mvlamis/wig/images_documentation/3d_prints/final_model_motor_case.png

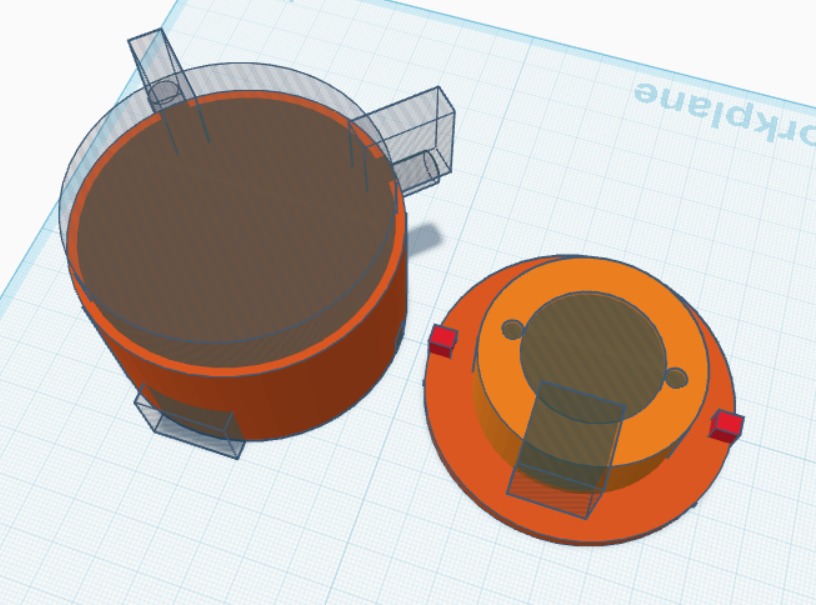
images_documentation/3d_prints/final_model_motor_case.png
