mvlamis/wig/README.md

# Infringement
**Michael Vlamis & Mars Lapierre-Furtado**

### [Code](./code)
### [Images](./images_documentation)
### [Diagrams](./diagrams)
### [Reports](./PDFs)
### [Technical Overview Video](https://youtu.be/p-mDJJXL3-0)
### [Conceptual Overview Video](https://youtu.be/cWO9dPNXsRk)
