mvlamis/wig/diagrams/early-blueprint.jpg

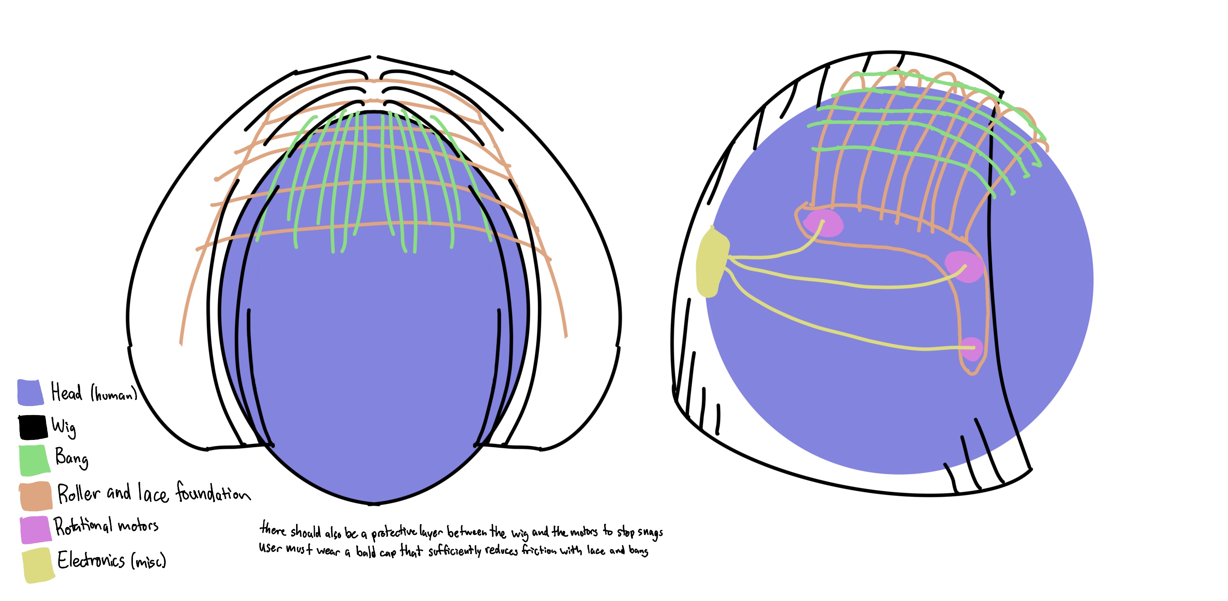
diagrams/early-blueprint.jpg
