mvlamis/wig/diagrams/motor-model.jpg

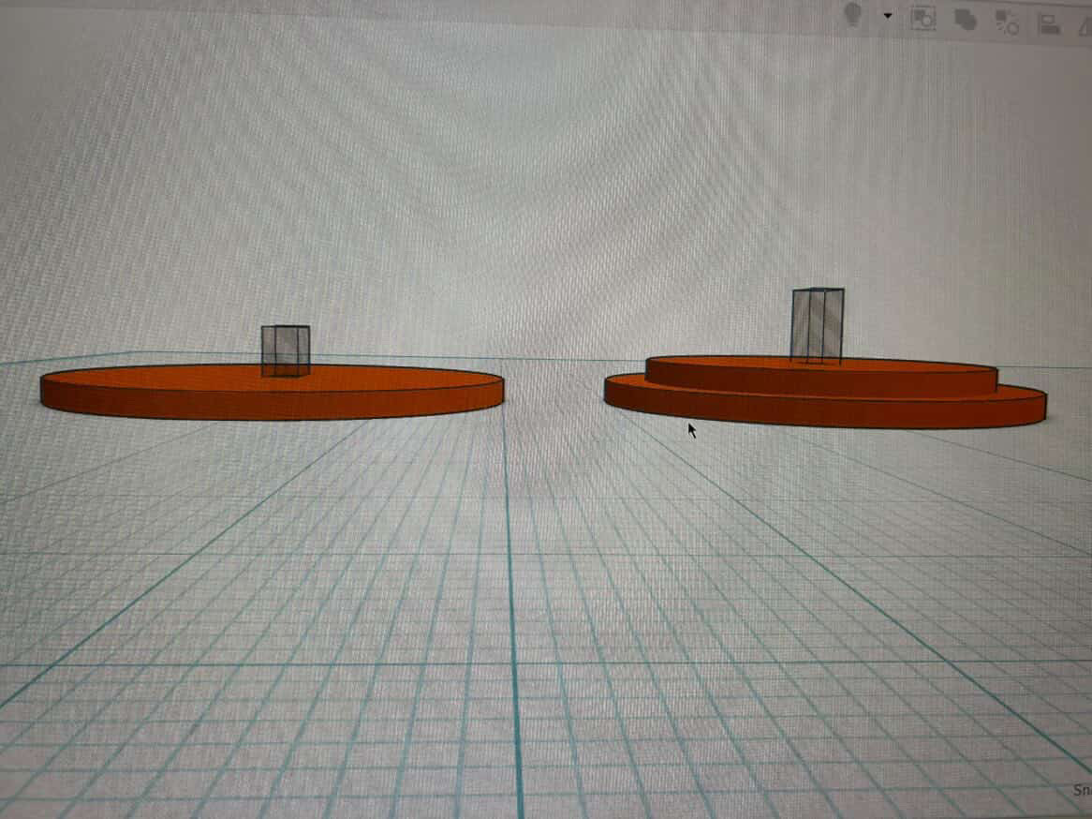
diagrams/motor-model.jpg
