mvlamis/wig/diagrams/sketch1.jpg

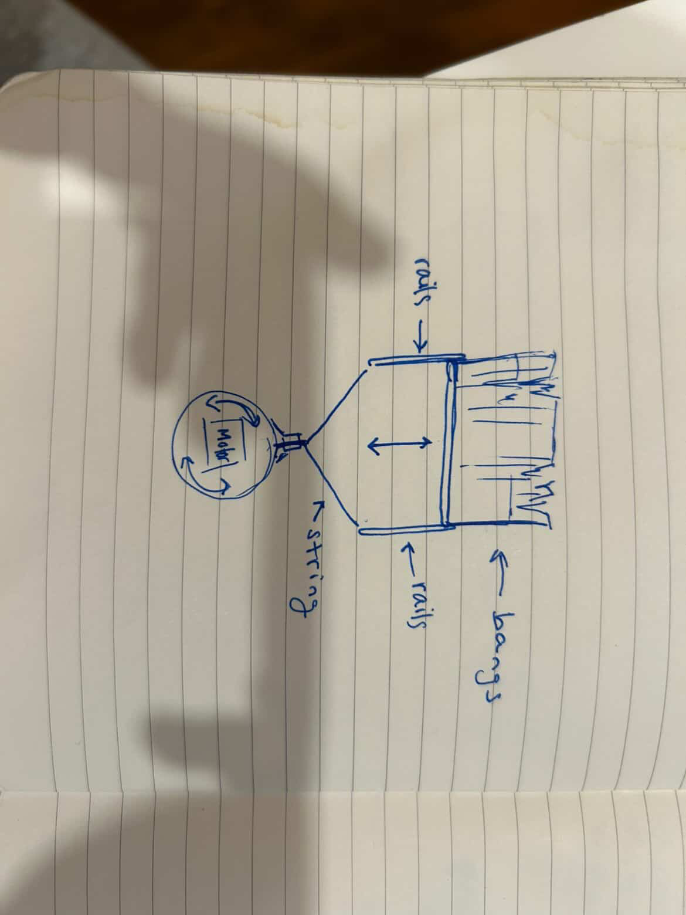
diagrams/sketch1.jpg
