mvlamis/wig/diagrams/sketch2.jpg

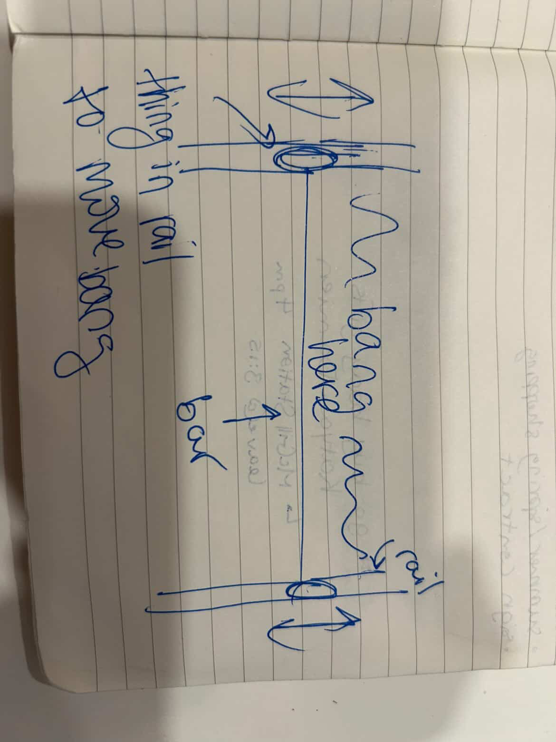
diagrams/sketch2.jpg
