mvlamis/wig/diagrams/Storyboard.png

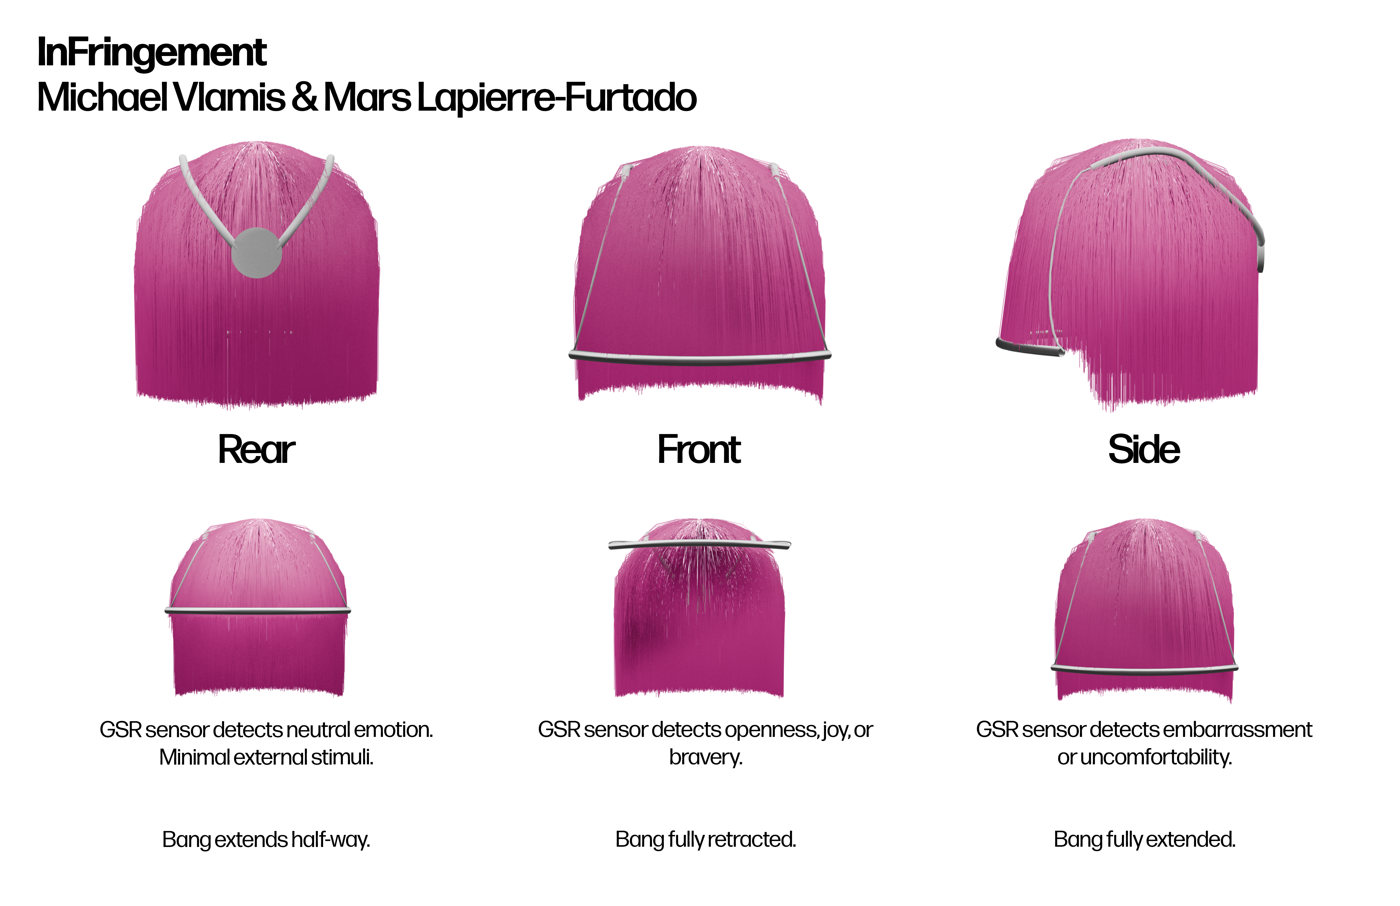
diagrams/Storyboard.png
