mvlamis/wig/diagrams/Wig Sketch_bb.png

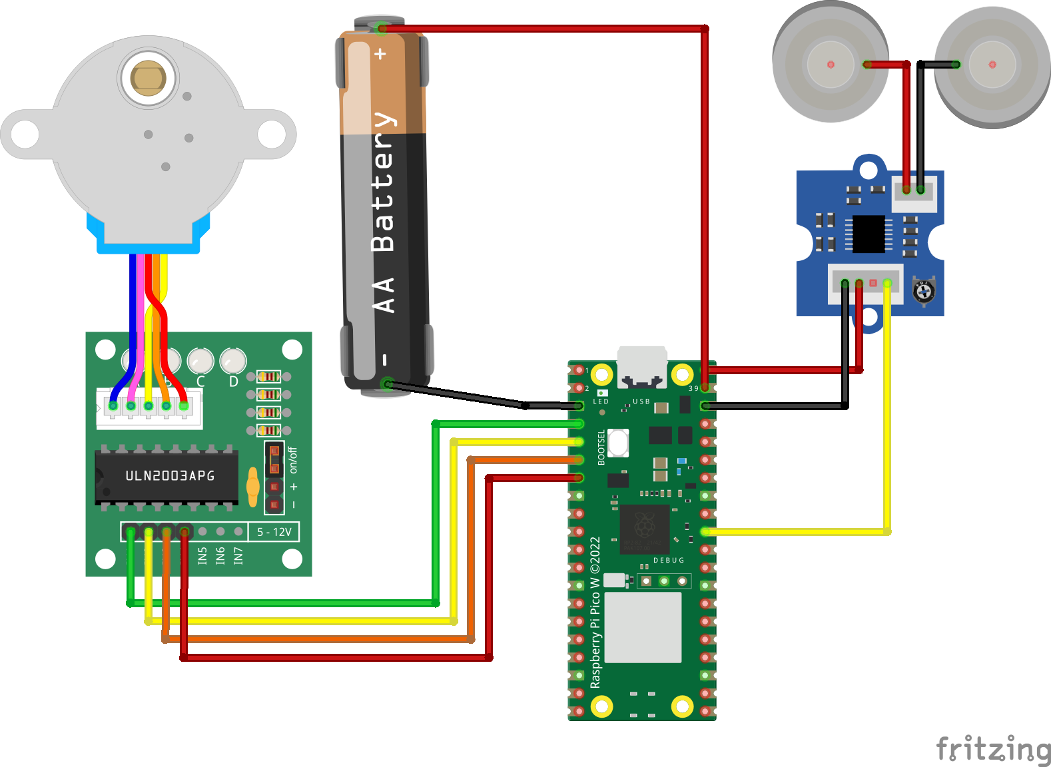
diagrams/Wig Sketch_bb.png
