mvlamis/wig/images_documentation/arm.JPG

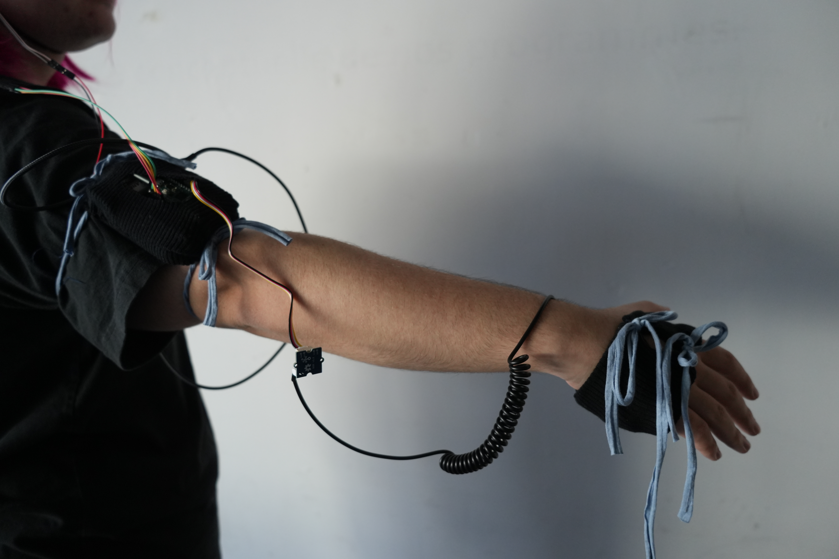
images_documentation/arm.JPG
