mvlamis/wig/images_documentation/fabric_secured.jpeg

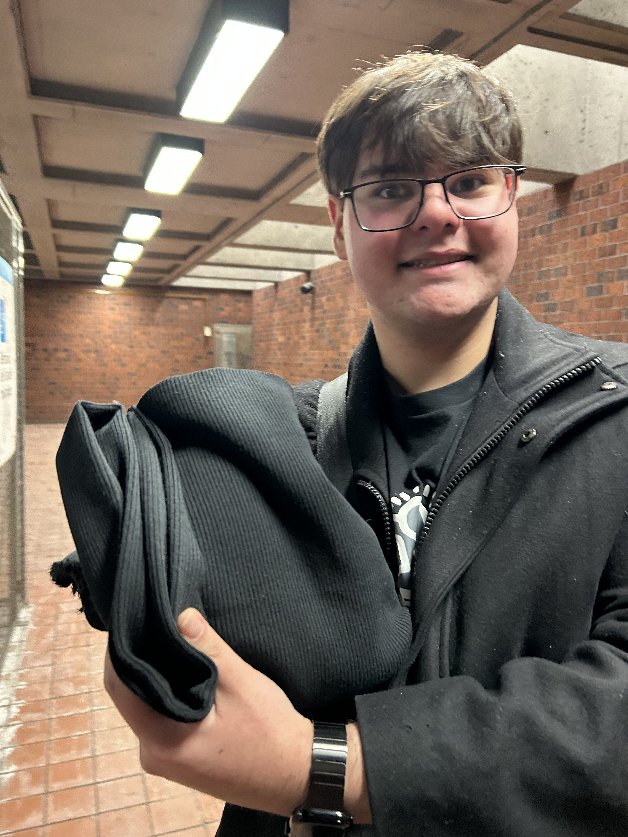
images_documentation/fabric_secured.jpeg
