mvlamis/wig/images_documentation/home_depot_success.jpg

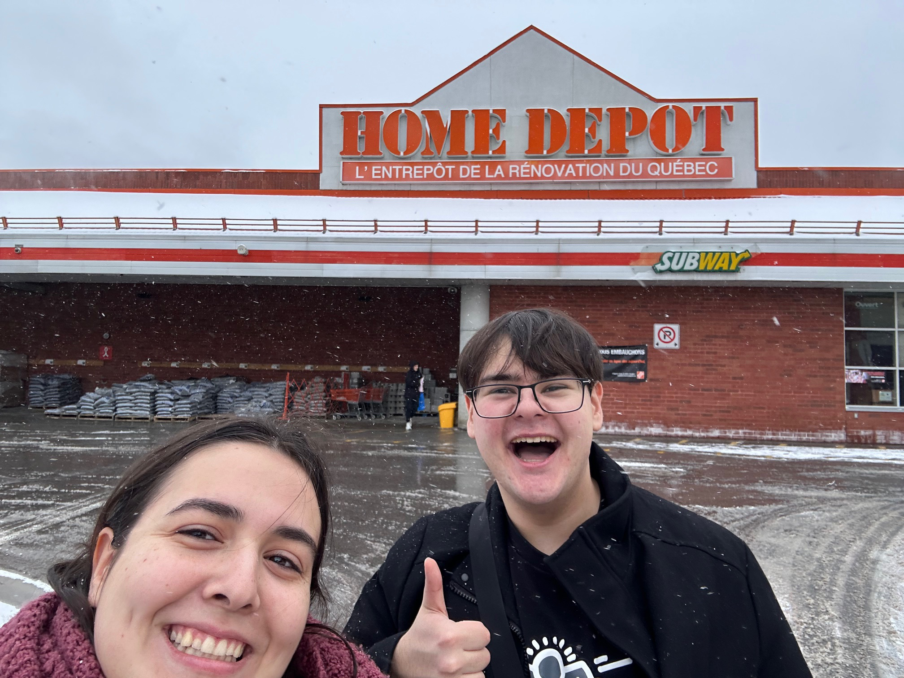
images_documentation/home_depot_success.jpg
