mvlamis/wig/images_documentation/sensor-concoction.jpeg

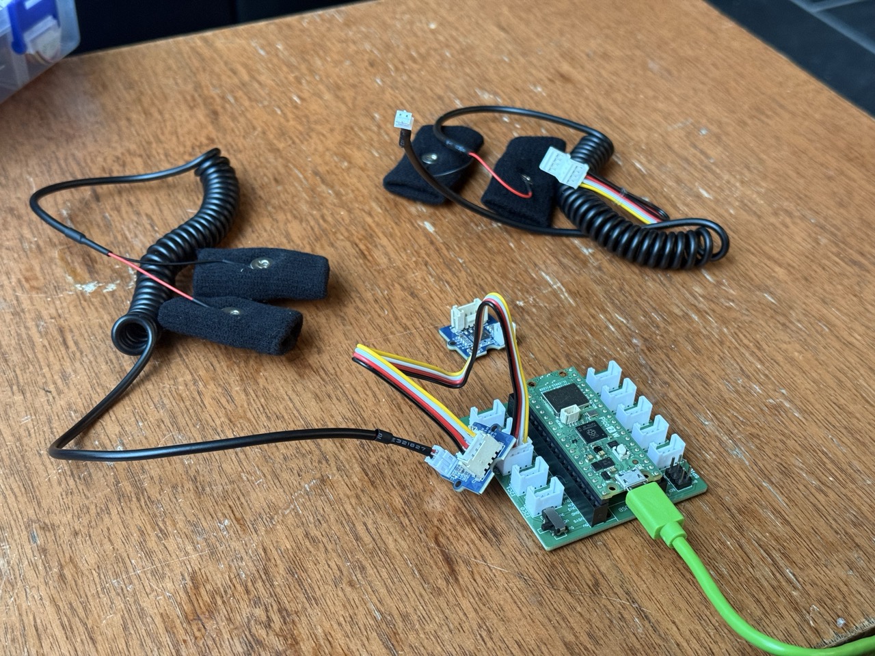
images_documentation/sensor-concoction.jpeg
