mvlamis/wig/images_documentation/sleeve.JPG

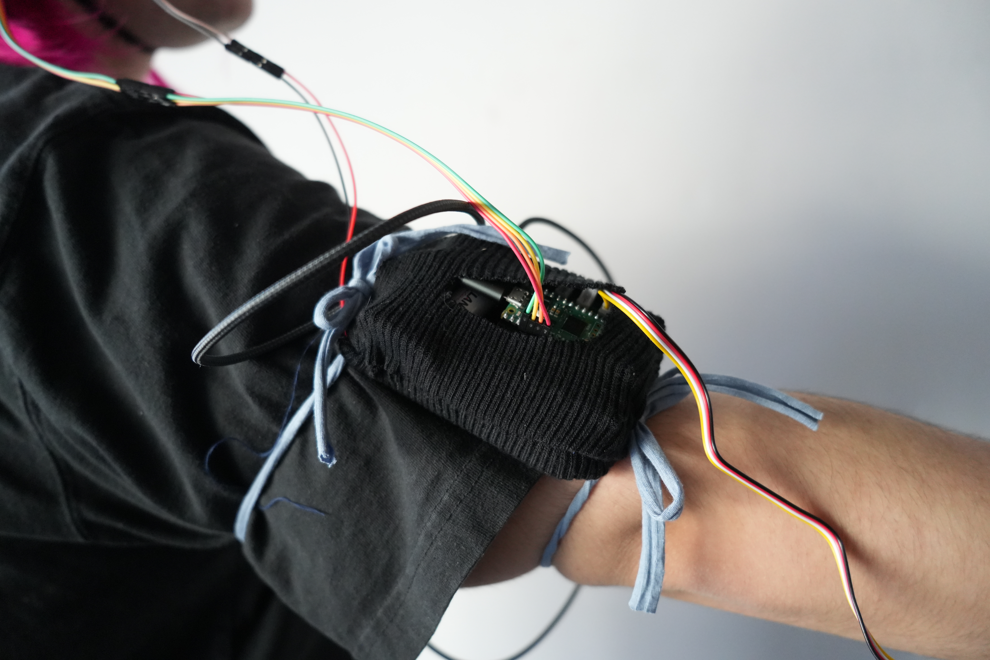
images_documentation/sleeve.JPG
