mvlamis/wig/visualizer/wig bang.png

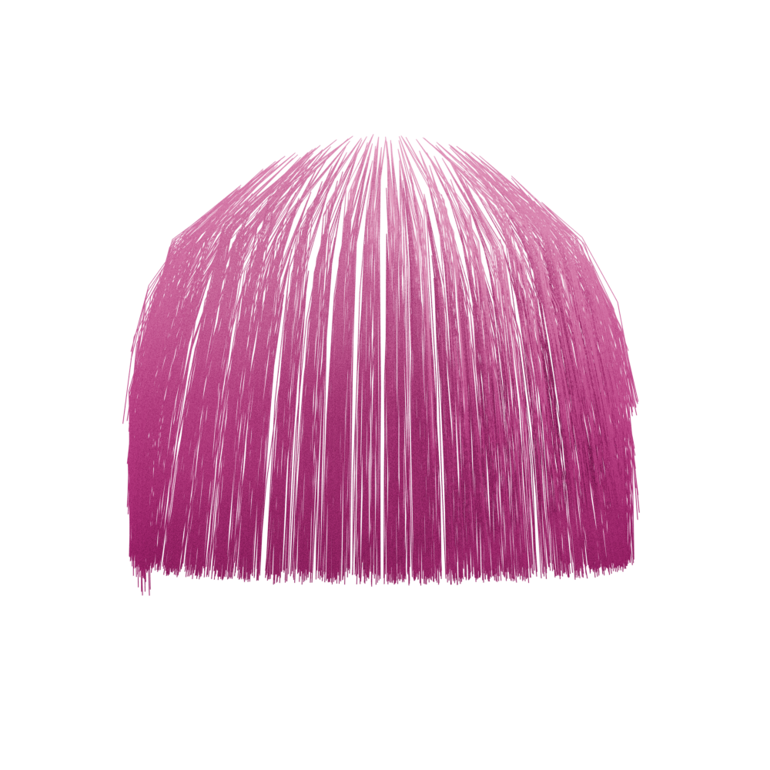
visualizer/wig bang.png
