mvlamis/wig/visualizer/wig base.png

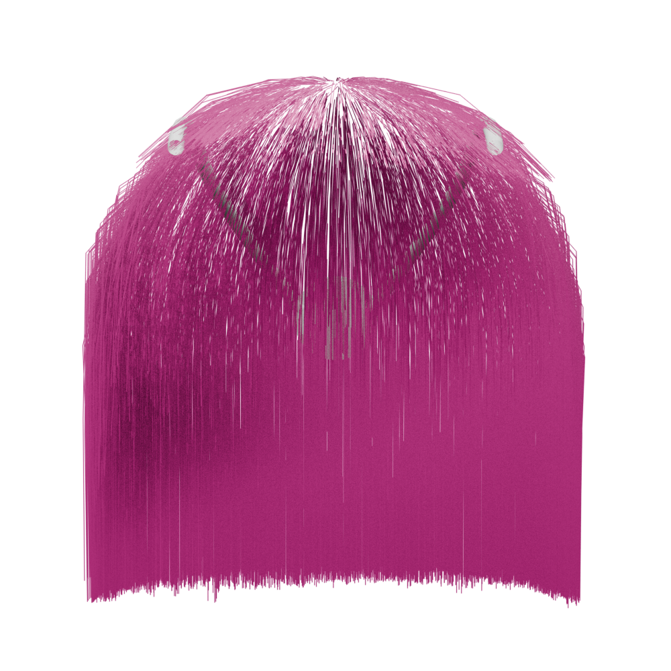
visualizer/wig base.png
