mvlamis/wig/images_documentation/3d_prints/final_model_spool.png

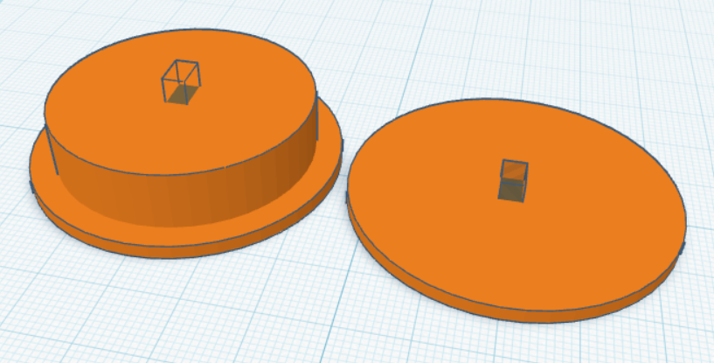
images_documentation/3d_prints/final_model_spool.png
