mvlamis/wig/images_documentation/motor-setup-macbook.jpeg

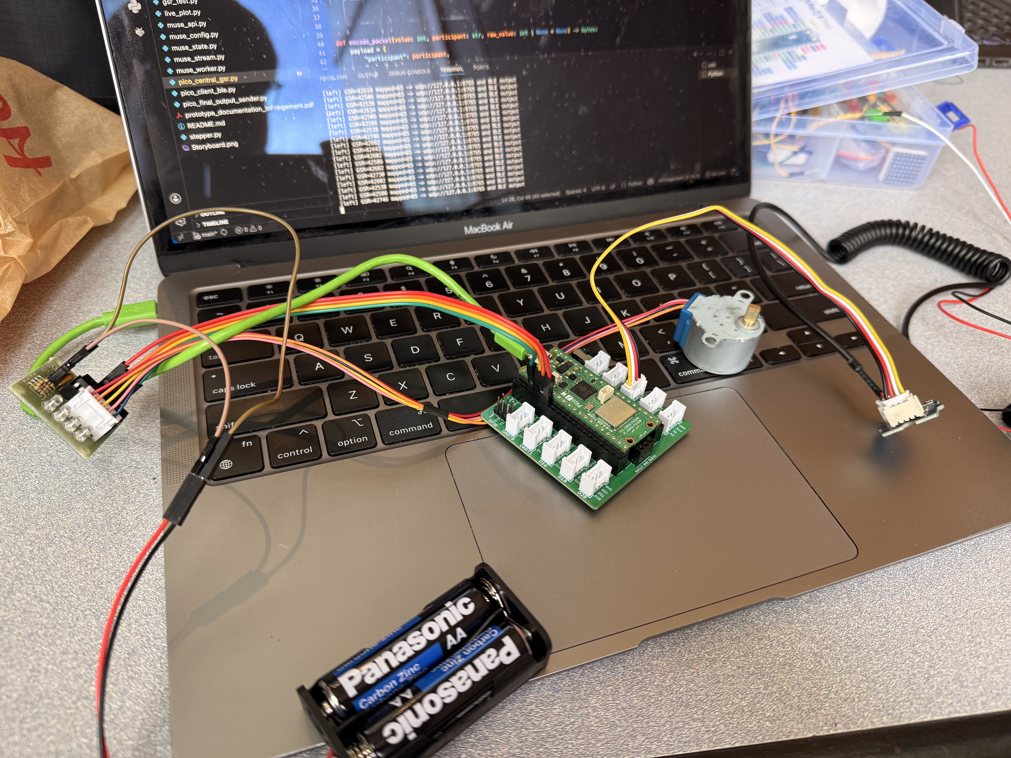
images_documentation/motor-setup-macbook.jpeg
