mvlamis/wig/images_documentation/bang_testing.png

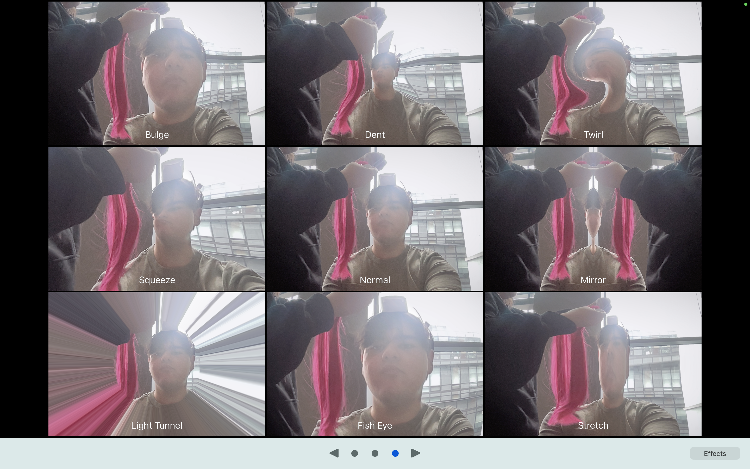
images_documentation/bang_testing.png
