mvlamis/wig/(list of files, drawings)

Other design files:
diagrams/Wig Sketch.fzz
