mvlamis/wig/code/pico_central_gsr.py

import asyncio
import json
import os
import socket
import struct
from urllib.error import URLError
from urllib.request import urlopen
from datetime import datetime
import time

from bleak import BleakClient, BleakScanner

GSR_SERVICE_UUID = "8ab3d6f0-4c07-4fe0-a22f-3e5ca9e7f100"
GSR_VALUE_UUID = "8ab3d6f0-4c07-4fe0-a22f-3e5ca9e7f101"
OUTPUT_VALUE_UUID = "8ab3d6f0-4c07-4fe0-a22f-3e5ca9e7f102"

PICO_NAME_PREFIX = os.getenv("WIG_PICO_NAME_PREFIX", "RPi-Pico-")

LEFT_ADDRESS = os.getenv("WIG_PICO_LEFT_ADDRESS", "").strip()
RIGHT_ADDRESS = os.getenv("WIG_PICO_RIGHT_ADDRESS", "").strip()

UDP_HOST = os.getenv("WIG_GSR_UDP_HOST", "127.0.0.1")
UDP_PORT = int(os.getenv("WIG_GSR_UDP_PORT", "8765"))

SCORE_API_HOST = os.getenv("WIG_SCORE_API_HOST", "localhost")
SCORE_API_PORT = int(os.getenv("WIG_SCORE_API_PORT", "8000"))
SCORE_API_URL = f"http://{SCORE_API_HOST}:{SCORE_API_PORT}/api/scores"
SCORE_POLL_INTERVAL_SEC = float(os.getenv("WIG_SCORE_POLL_INTERVAL_SEC", "0.5"))

RECONNECT_DELAY_SEC = 2.0
SCAN_TIMEOUT_SEC = 10.0


def scale_gsr_to_percent(raw_value: int) -> int:
    clamped = max(0, min(65535, int(raw_value)))
    return 1 + (clamped * 99) // 65535
    # # test with moving between 0 <-> 100 over time
    # period_sec = 30.0
    # t = time.monotonic() % period_sec
    # if t < period_sec / 2:
    #     return int((t / (period_sec / 2)) * 100)
    # else:        return int(((period_sec - t) / (period_sec / 2)) * 100)




def encode_packet(value: int, participant: str, raw_value: int | None = None) -> bytes:
    payload = {
        "participant": participant,
        "value": value,
        "timestamp": datetime.now().isoformat(timespec="milliseconds"),
    }
    if raw_value is not None:
        payload["raw_value"] = raw_value
    return json.dumps(payload).encode("utf-8")


def participant_from_name(name: str | None) -> str | None:
    if not name:
        return None
    if not name.startswith(PICO_NAME_PREFIX):
        return None
    suffix = name[len(PICO_NAME_PREFIX):].strip().lower()
    if suffix in ("left", "right"):
        return suffix
    return None


def clamp_percent(value: float) -> int:
    return max(1, min(100, int(round(value))))


def fetch_fused_scores() -> dict[str, int]:
    with urlopen(SCORE_API_URL, timeout=2.0) as response:
        payload = json.loads(response.read().decode("utf-8"))

    participants = payload.get("participants", {})
    scores: dict[str, int] = {}
    for participant_id, participant_payload in participants.items():
        try:
            score_value = participant_payload.get("fused_score", participant_payload.get("score"))
            if score_value is None:
                continue
            scores[str(participant_id)] = clamp_percent(float(score_value))
        except (TypeError, ValueError):
            continue

    return scores


async def find_device_for_participant(participant: str):
    target_address = LEFT_ADDRESS if participant == "left" else RIGHT_ADDRESS
    if target_address:
        return await BleakScanner.find_device_by_address(target_address, timeout=SCAN_TIMEOUT_SEC)

    devices = await BleakScanner.discover(timeout=SCAN_TIMEOUT_SEC)
    for device in devices:
        role = participant_from_name(device.name)
        if role == participant:
            return device
    return None


async def stream_participant(participant: str, udp_sock: socket.socket, score_cache: dict[str, int]):
    async def write_output_value(client: BleakClient, percent: int):
        try:
            await client.write_gatt_char(
                OUTPUT_VALUE_UUID,
                struct.pack("<H", percent),
                response=True,
            )
        except Exception as exc:
            print(f"[{participant}] Failed to write output value {percent}: {exc}")

    while True:
        try:
            device = await find_device_for_participant(participant)
            if device is None:
                print(f"[{participant}] Peripheral not found; retrying scan...")
                await asyncio.sleep(RECONNECT_DELAY_SEC)
                continue

            print(f"[{participant}] Connecting to {device.address} ({device.name})...")
            async with BleakClient(device) as client:
                print(f"[{participant}] Connected.")

                def handle_notification(_: int, data: bytearray):
                    if len(data) < 2:
                        return
                    raw_gsr_value = struct.unpack("<H", data[:2])[0]
                    gsr_percent = scale_gsr_to_percent(raw_gsr_value)
                    control_percent = clamp_percent(score_cache.get(participant, gsr_percent))
                    udp_sock.sendto(
                        encode_packet(gsr_percent, participant, raw_value=raw_gsr_value),
                        (UDP_HOST, UDP_PORT),
                    )
                    asyncio.create_task(write_output_value(client, control_percent))
                    print(
                        f"[{participant}] GSR={raw_gsr_value} mapped={gsr_percent} -> "
                        f"udp://{UDP_HOST}:{UDP_PORT}; fused={control_percent} -> BLE output"
                    )

                await client.start_notify(GSR_VALUE_UUID, handle_notification)
                print(f"[{participant}] Subscribed to GSR notifications")

                while client.is_connected:
                    await asyncio.sleep(1.0)

        except asyncio.CancelledError:
            raise
        except Exception as exc:
            print(f"[{participant}] Central error: {exc}")

        await asyncio.sleep(RECONNECT_DELAY_SEC)


async def refresh_scores(score_cache: dict[str, int]):
    while True:
        try:
            latest_scores = await asyncio.to_thread(fetch_fused_scores)
            if latest_scores:
                score_cache.update(latest_scores)
        except URLError as exc:
            print(f"Score API unavailable ({exc}); using last known scores.")
        except Exception as exc:
            print(f"Score refresh failed: {exc}")

        await asyncio.sleep(SCORE_POLL_INTERVAL_SEC)


async def run() -> None:
    udp_sock = socket.socket(socket.AF_INET, socket.SOCK_DGRAM)
    score_cache: dict[str, int] = {"left": 50, "right": 50}

    print("Starting dual GSR central (left + right)")
    tasks = [
        asyncio.create_task(stream_participant("left", udp_sock, score_cache)),
        asyncio.create_task(stream_participant("right", udp_sock, score_cache)),
        asyncio.create_task(refresh_scores(score_cache)),
    ]
    try:
        await asyncio.gather(*tasks)
    finally:
        for task in tasks:
            task.cancel()
        udp_sock.close()


if __name__ == "__main__":
    asyncio.run(run())
