mvlamis/wig/(commit log)

2026-03-09 gsr sensor test
2026-03-10 prototype documentation
2026-04-13 bluetooth gsr from pico, multiple muse headsets, redo visualizer
2026-04-17 bluetooth motor control
2026-04-18 api with both gsr and muse, send fused score to client
2026-04-18 fritzing sketch and one picture
    [Wig Sketch.fzz]
2026-04-19 tune motor steps and add weight adjustment to api
2026-04-21 reorganize repo for submission, add manual wireless stepper control, images
    [Wig Sketch.fzz]
