mvlamis/wig/images_documentation/gsr_glove_final.jpeg

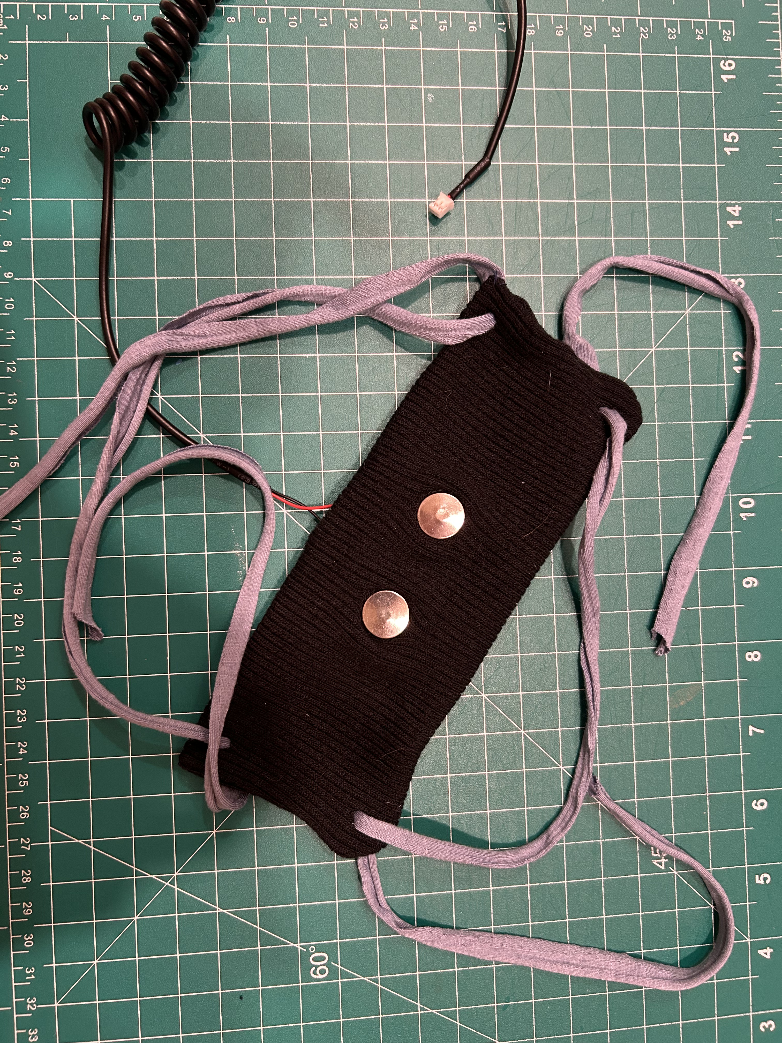
images_documentation/gsr_glove_final.jpeg
