mvlamis/wig/images_documentation/gsr_glove_fitting.jpeg

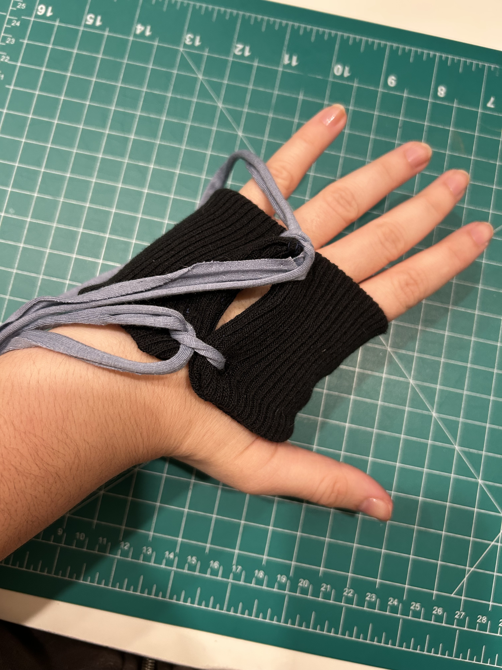
images_documentation/gsr_glove_fitting.jpeg
