mvlamis/wig/images_documentation/gsr_glove_sewing.jpeg

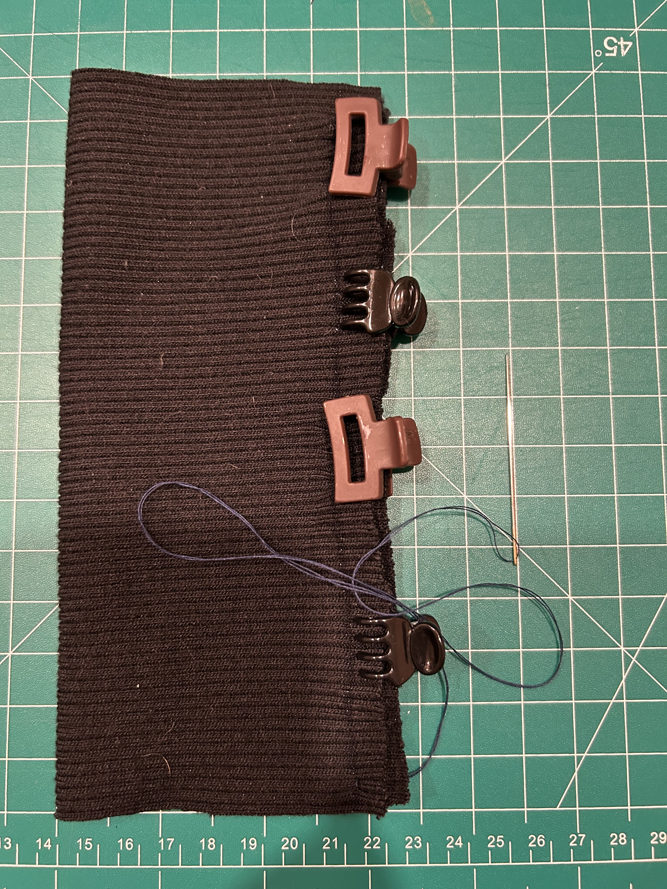
images_documentation/gsr_glove_sewing.jpeg
