mvlamis/wig/images_documentation/michael_front.JPG

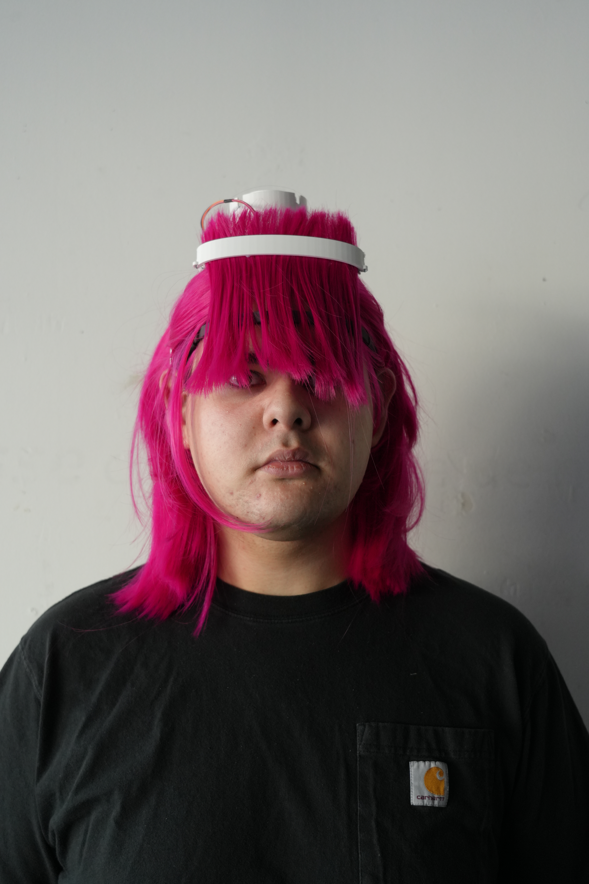
images_documentation/michael_front.JPG
