mvlamis/wig/images_documentation/michael_full.JPG

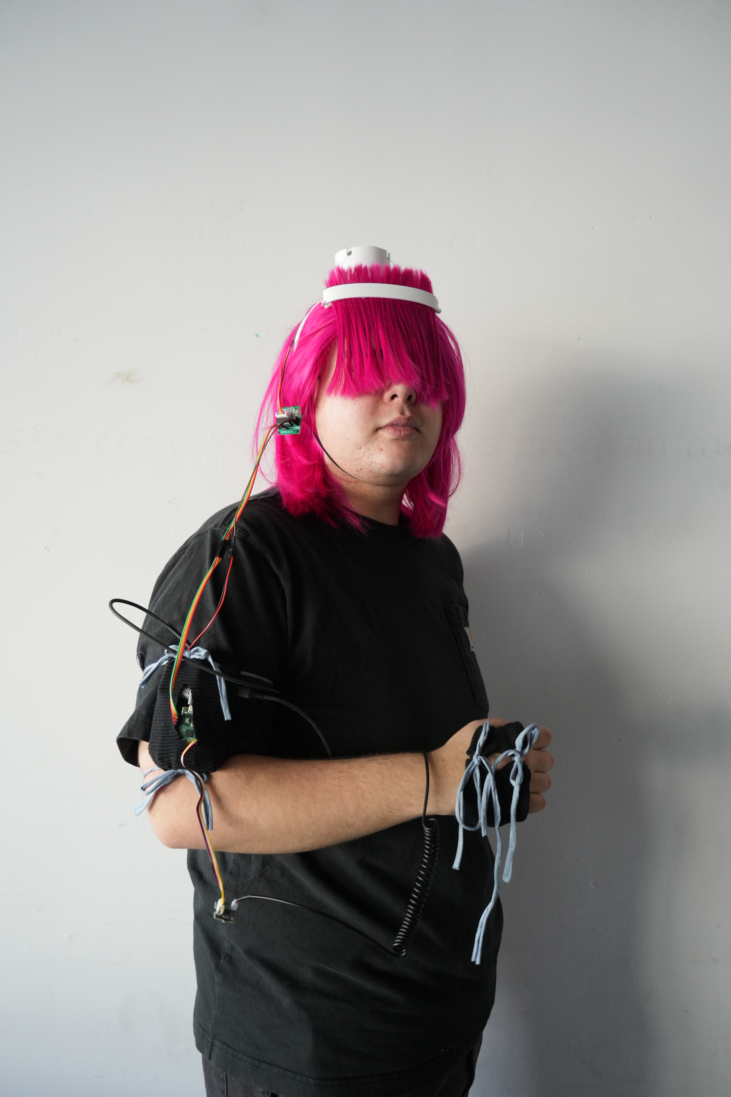
images_documentation/michael_full.JPG
