mvlamis/wig/images_documentation/michael_profile.JPG

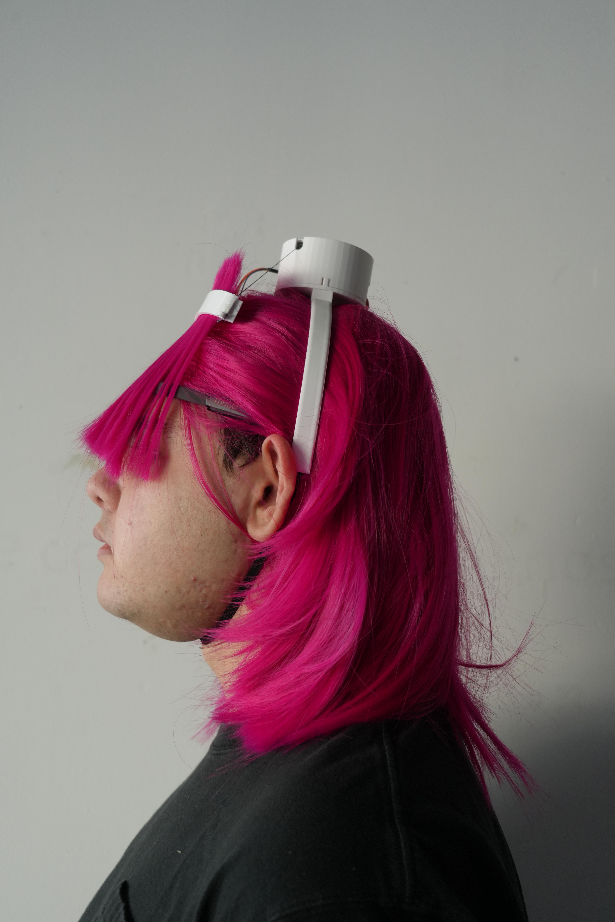
images_documentation/michael_profile.JPG
