mvlamis/wig/images_documentation/pico_gsr_motor_battery.jpeg

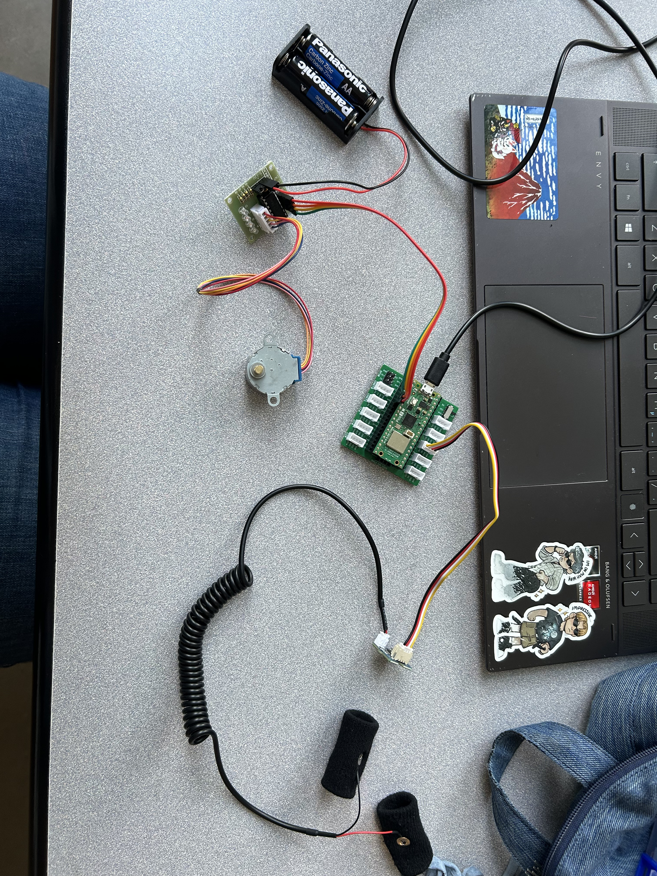
images_documentation/pico_gsr_motor_battery.jpeg
