mvlamis/wig/images_documentation/pico_motor_closeup.jpeg

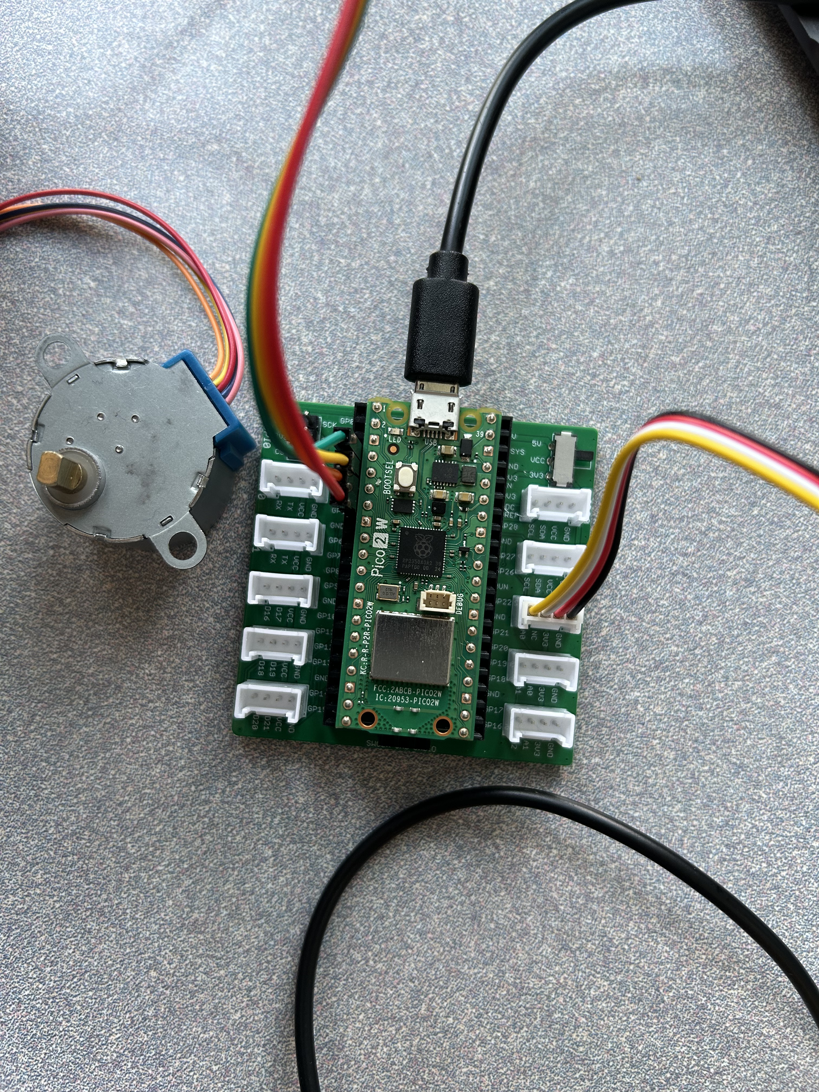
images_documentation/pico_motor_closeup.jpeg
