mvlamis/wig/images_documentation/tubing_secured.jpeg

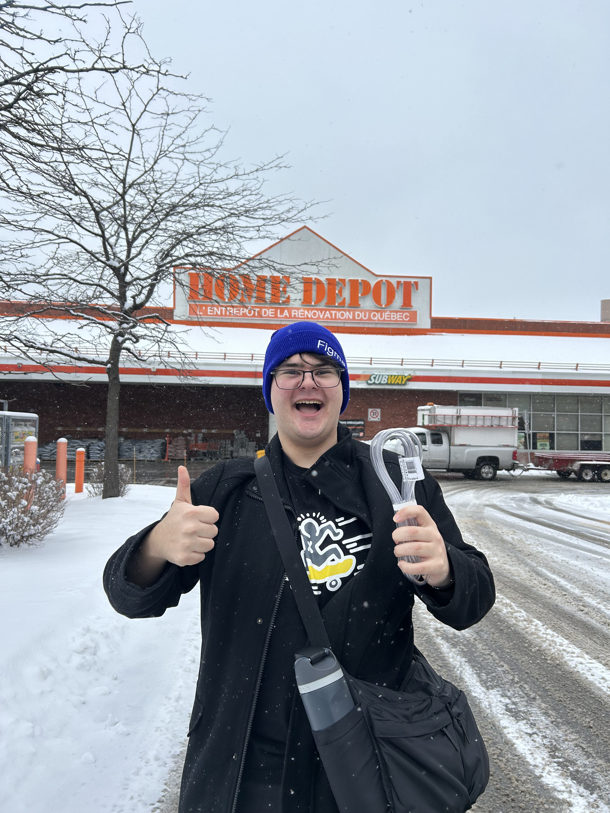
images_documentation/tubing_secured.jpeg
