mvlamis/wig/images_documentation/3d_prints/headband_printing.jpeg

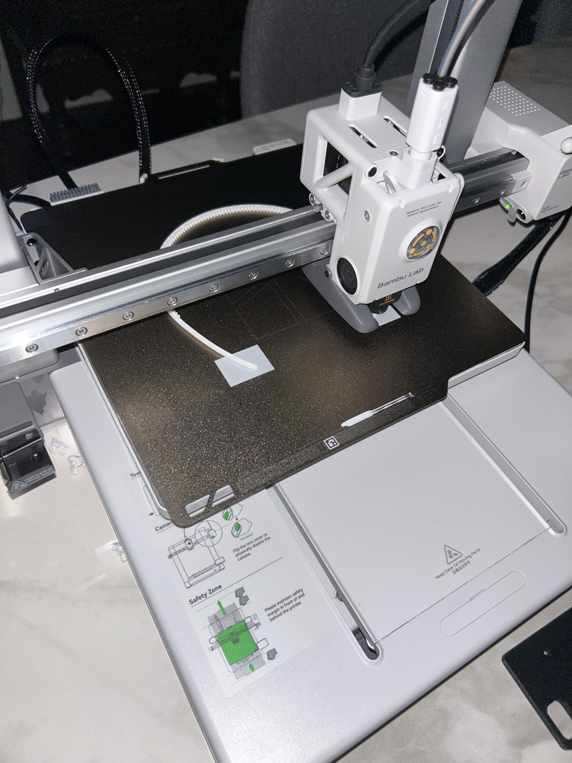
images_documentation/3d_prints/headband_printing.jpeg
