mvlamis/wig/images_documentation/3d_prints/motor_case_iterating.jpeg

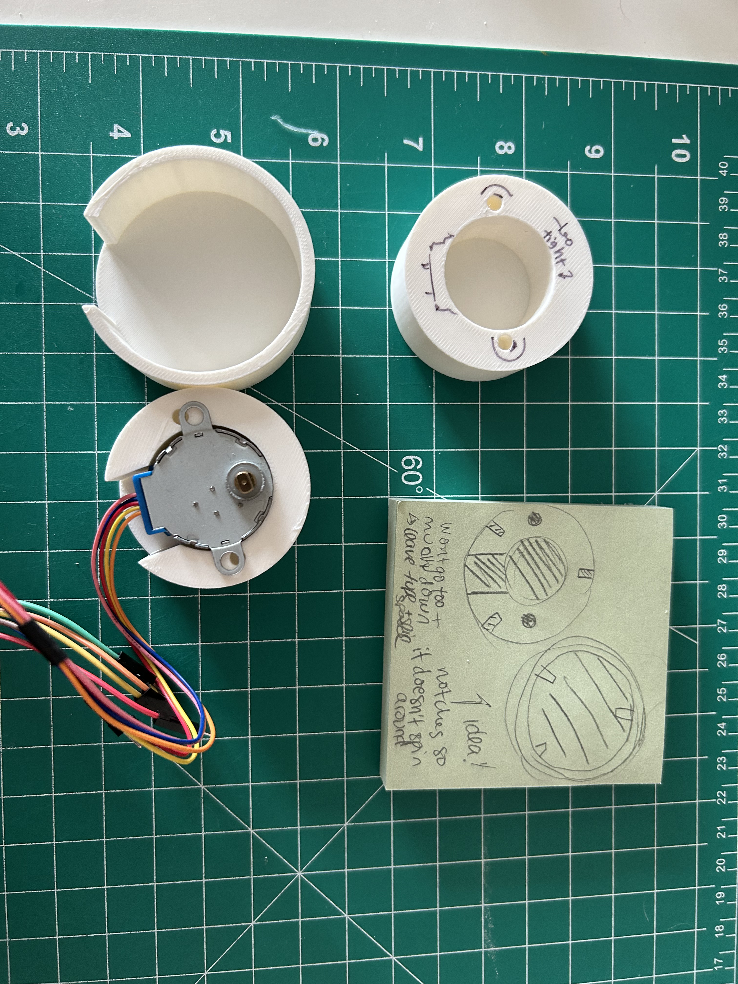
images_documentation/3d_prints/motor_case_iterating.jpeg
