mvlamis/wig/images_documentation/3d_prints/motor_case_headband.jpeg

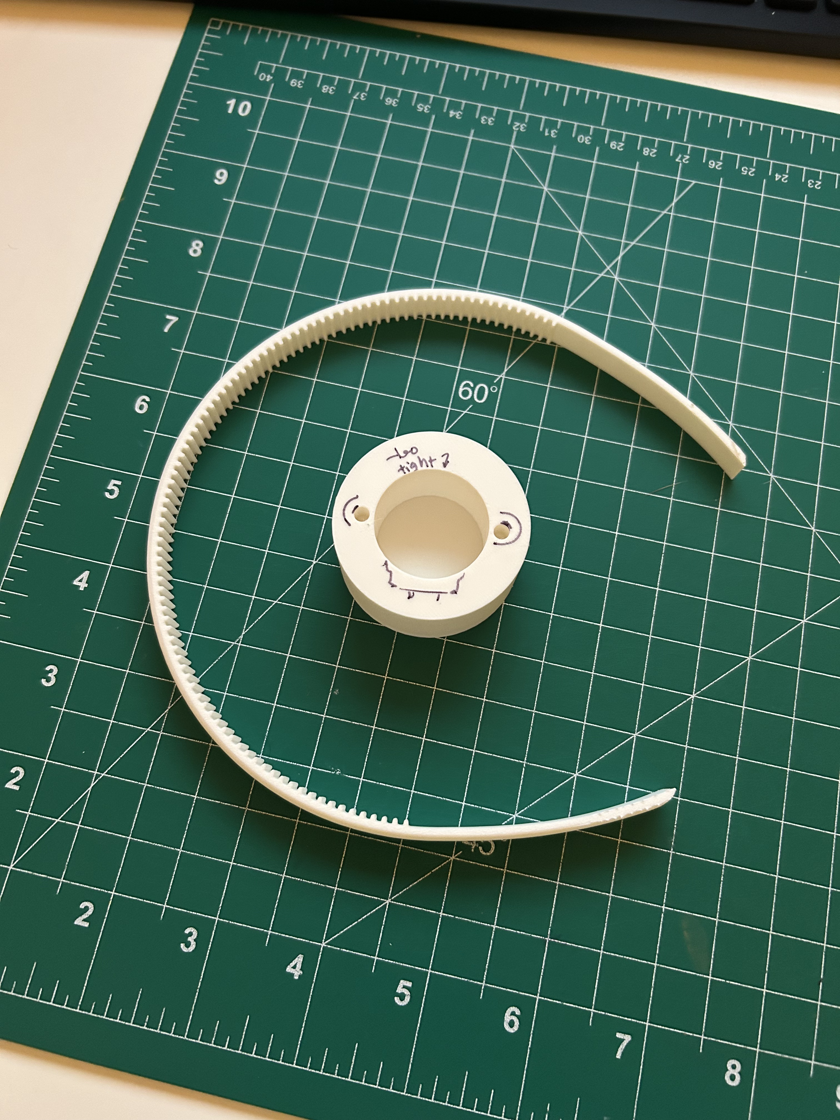
images_documentation/3d_prints/motor_case_headband.jpeg
